joaoandre26/developedwork/(list of files, cad)

Other CAD files:
CCSproj/ImpFloatfft/Debug/src/timer0A0.obj
CCSproj/TestProject/Debug/src/uart.obj
CCSproj/ImpFloatfft/Debug/src/spectral_analysisf.obj
CCSproj/ImpFloatfft/Debug/src/uart.obj
CCSproj/ImpFloatfft/Debug/src/float_fft.obj
