joaoandre26/developedwork/KicadFiles/PiezzCircuit/output/circ.pdf

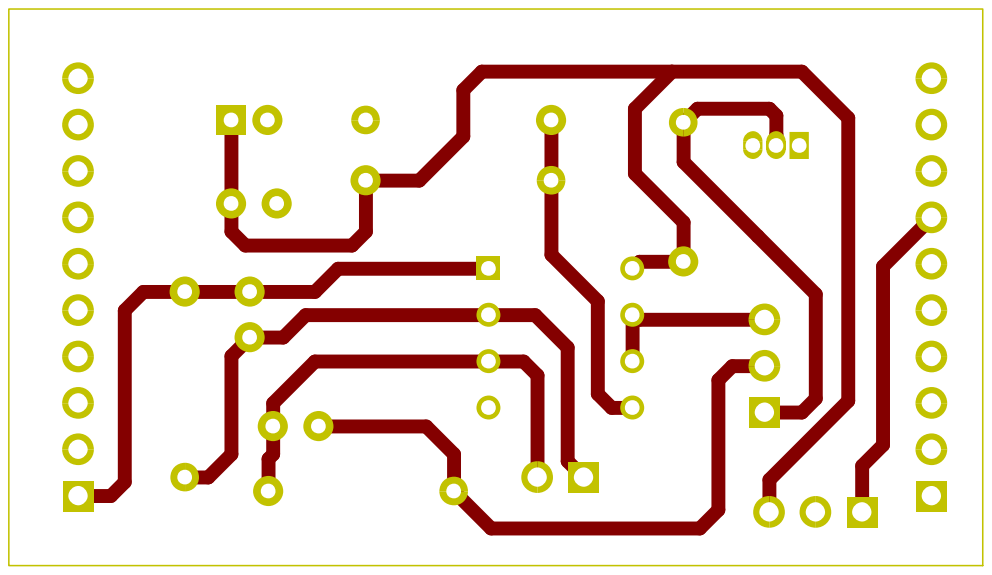
[picture p10: page 1]

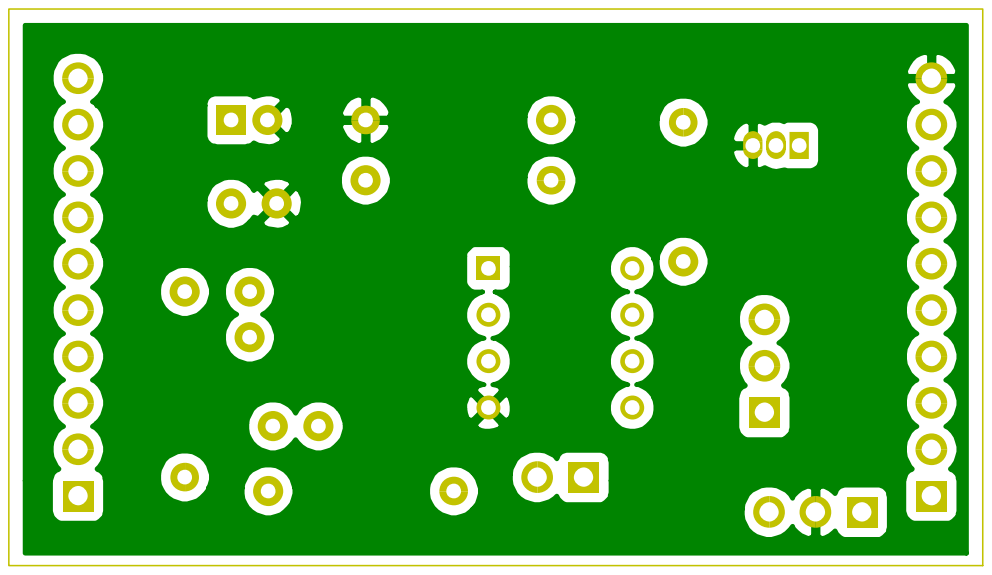
[picture p11: page 2]
