joaoandre26/developedwork/KicadFiles/AccCirc/circAcc.pdf

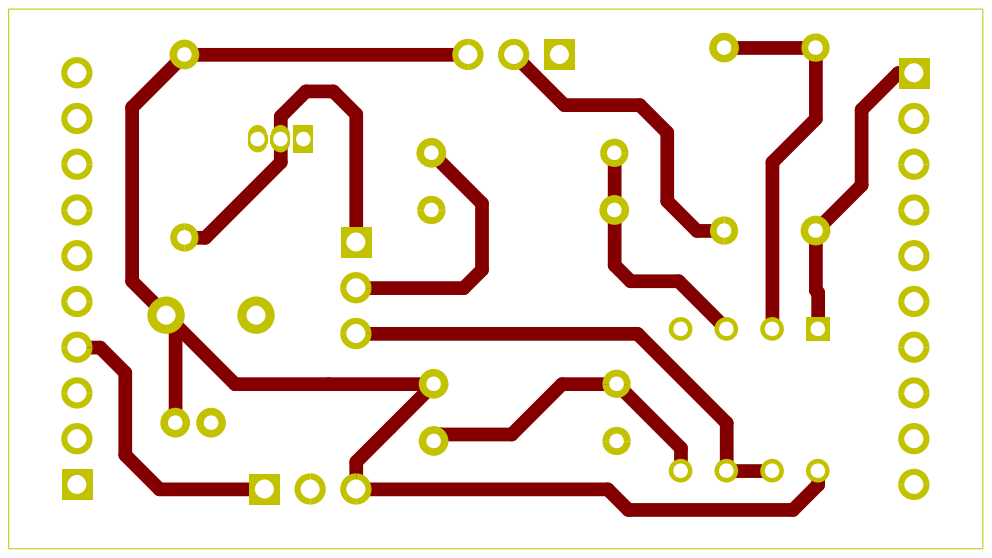
[picture p12: page 1]

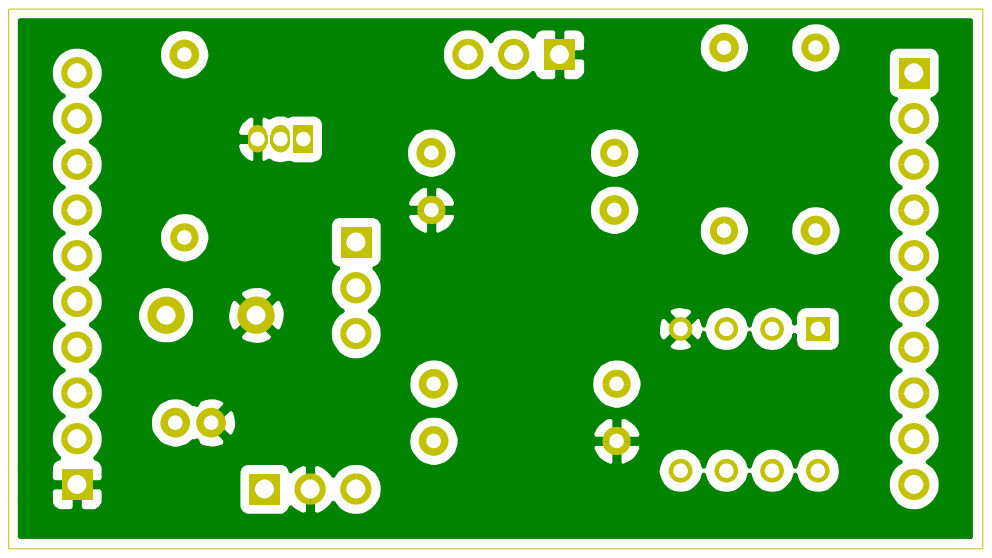
[picture p13: page 2]
