joaoandre26/developedwork/KicadFiles/AccCircV2/AccCircV2.kicad_pcb

## KiCad design KicadFiles/AccCircV2/AccCircV2.kicad_pcb (2021-06-03)

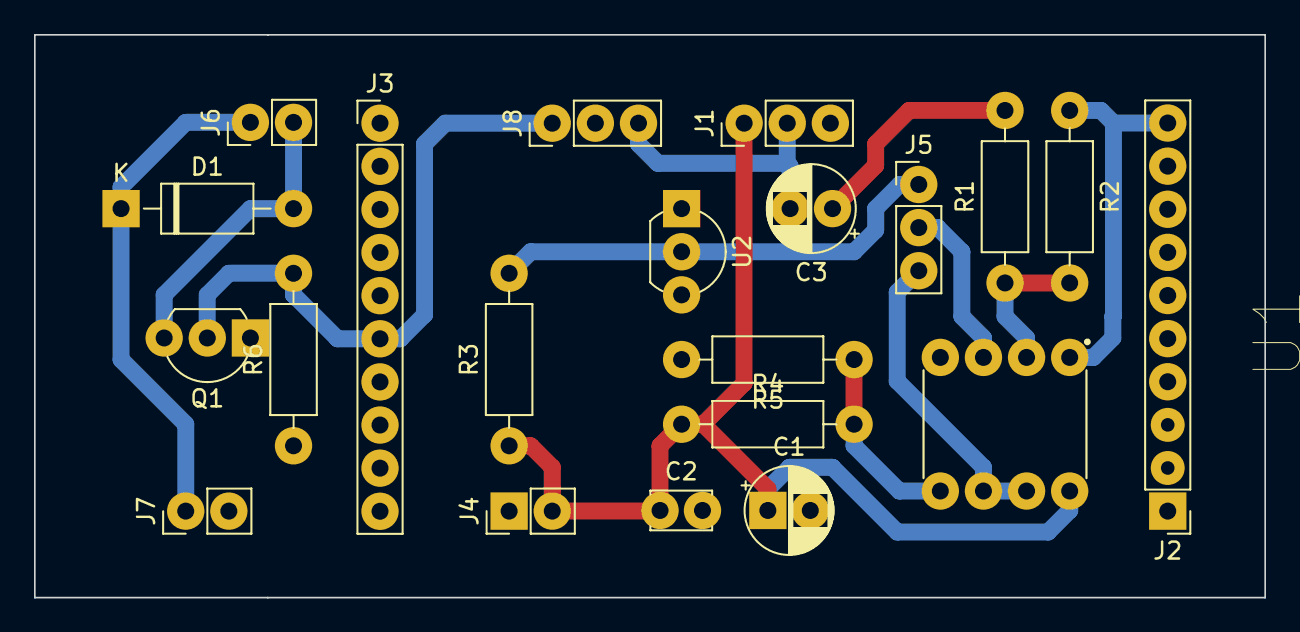
[picture p14: board AccCircV2.kicad_pcb from above]

Board: 2 copper layers, 72.5 x 33.2 mm, 21 parts (0 on the bottom side), 13 nets.

Parts:
C1, C3: 10uF; CP_Radial_D5.0mm_P2.50mm
C2: 1nF; C_Disc_D3.4mm_W2.1mm_P2.50mm
D1: 1N4001; D_DO-41_SOD81_P10.16mm_Horizontal
J1: AccelConnector; PinHeader_1x03_P2.54mm_Vertical
J2: ADCInput; PinHeader_1x10_P2.54mm_Vertical
J3: IO; PinHeader_1x10_P2.54mm_Vertical
J4: ExternalSupply3V3; PinHeader_1x02_P2.54mm_Vertical
J5: VoltageRefSel; PinHeader_1x03_P2.54mm_Vertical
J6: Solenoid Connector; PinHeader_1x02_P2.54mm_Vertical
J7: ExternalSupply5V; PinHeader_1x02_P2.54mm_Vertical
J8: ControlSig; PinHeader_1x03_P2.54mm_Vertical
Q1: TN0207; TO-92L_Inline_Wide
R1, R2, R4, R5: R; R_Axial_DIN0207_L6.3mm_D2.5mm_P10.16mm_Horizontal
R3: 180k; R_Axial_DIN0207_L6.3mm_D2.5mm_P10.16mm_Horizontal
R6: 10k; R_Axial_DIN0207_L6.3mm_D2.5mm_P10.16mm_Horizontal
U1: MCP602; DIP787W46P254L927H533Q8
U2: LM385Z-ADJ; TO-92_Inline_Wide

Connections:
+3V3: C1.1, C2.1, J1.1, J4.2, R3.1, R4.1, U1.8
+5V: D1.1, J6.1, J7.1
AccSignal: C3.2, J1.2, J8.3
GND: C1.2, C2.2, J1.3, J3.10, J4.1, J7.2, J8.2, Q1.1, R5.2, R6.1, U1.4, U2.1, U2.3
unnamed: C3.1, R1.2
unnamed: D1.2, J6.2, Q1.3
unnamed: J2.10, R2.1, U1.1
unnamed: J5.2, U1.3
unnamed: R1.1, R2.2, U1.2
unnamed: R4.2, R5.1, U1.5
PIN3.2: J3.6, J8.1, Q1.2, R6.2
VolDivider: J5.3, U1.6, U1.7
VolRef1V2: J5.1, R3.2, U2.2
