joaoandre26/developedwork/KicadFiles/PiezzCircuit/PiezzCircuit.kicad_pcb

## KiCad design KicadFiles/PiezzCircuit/PiezzCircuit.kicad_pcb (2020-12-22)

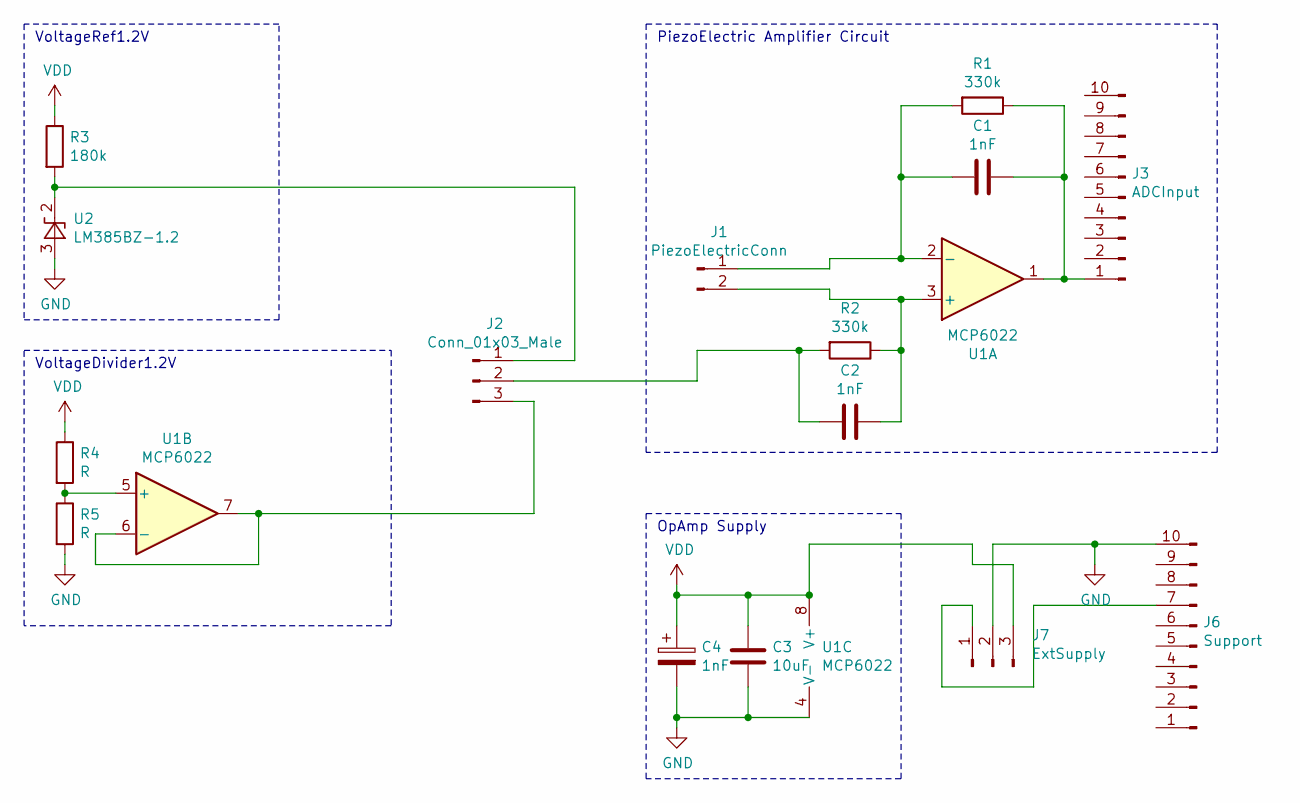
[picture p15: schematic PiezzCircuit.sch]

Parts:
C1, C2: 1nF; C_Rect_L4.0mm_W2.5mm_P2.50mm
C3: 10uF; C_Rect_L4.0mm_W2.5mm_P2.50mm
C4: 1nF; CP_Radial_D5.0mm_P2.00mm
J1: PiezoElectricConn; PinHeader_1x02_P2.54mm_Vertical
J2: Conn_01x03_Male; PinHeader_1x03_P2.54mm_Vertical
J3: ADCInput; PinHeader_1x10_P2.54mm_Vertical
J6: Support; PinHeader_1x10_P2.54mm_Vertical
J7: ExtSupply; PinHeader_1x03_P2.54mm_Horizontal
R1, R2: 330k; R_Axial_DIN0207_L6.3mm_D2.5mm_P10.16mm_Horizontal
R3: 180k; R_Axial_DIN0207_L6.3mm_D2.5mm_P7.62mm_Horizontal
R4, R5: R; R_Axial_DIN0207_L6.3mm_D2.5mm_P10.16mm_Horizontal
U1: MCP6022; DIP787W46P254L927H533Q8
U2: LM385BZ-1.2; TO-92_Inline

Connections:
GND: C3.2, C4.2, J6.10, J7.2, R5.2, U1.4 (V-), U2.3 (A)
unnamed: C1.1, J3.1, R1.1, U1.1
unnamed: C1.2, J1.1, R1.2, U1.2 (-)
unnamed: C2.1, J1.2, R2.1, U1.3 (+)
unnamed: C2.2, J2.2, R2.2
unnamed: J2.1, R3.2, U2.2 (K)
unnamed: J2.3, U1.6 (-), U1.7
unnamed: J6.7, J7.1
unnamed: R4.2, R5.1, U1.5 (+)
VDD: C3.1, C4.1, J7.3, R3.1, R4.1, U1.8 (V+)

Notes on the sheet:
VoltageRef1.2V
VoltageDivider1.2V
PiezoElectric Amplifier Circuit
OpAmp Supply

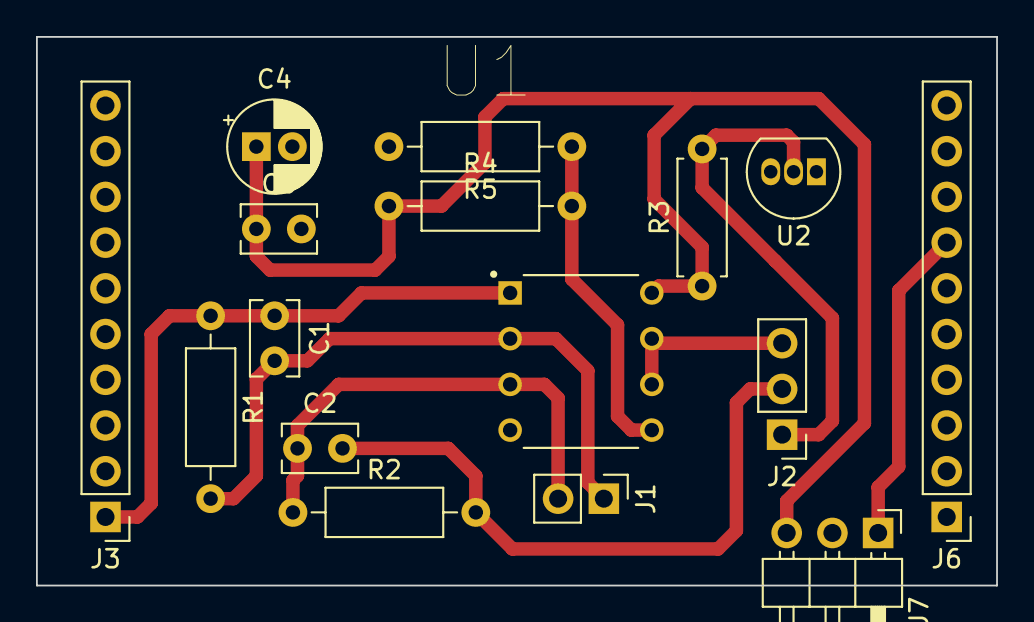
[picture p16: board PiezzCircuit.kicad_pcb from above]

Board: 2 copper layers, 53.3 x 30.5 mm, 16 parts (0 on the bottom side), 10 nets.
