joaoandre26/developedwork/KicadFiles/AccCirc/AccCirc.kicad_pcb

## KiCad design KicadFiles/AccCirc/AccCirc.kicad_pcb (2020-12-10, an earlier design)

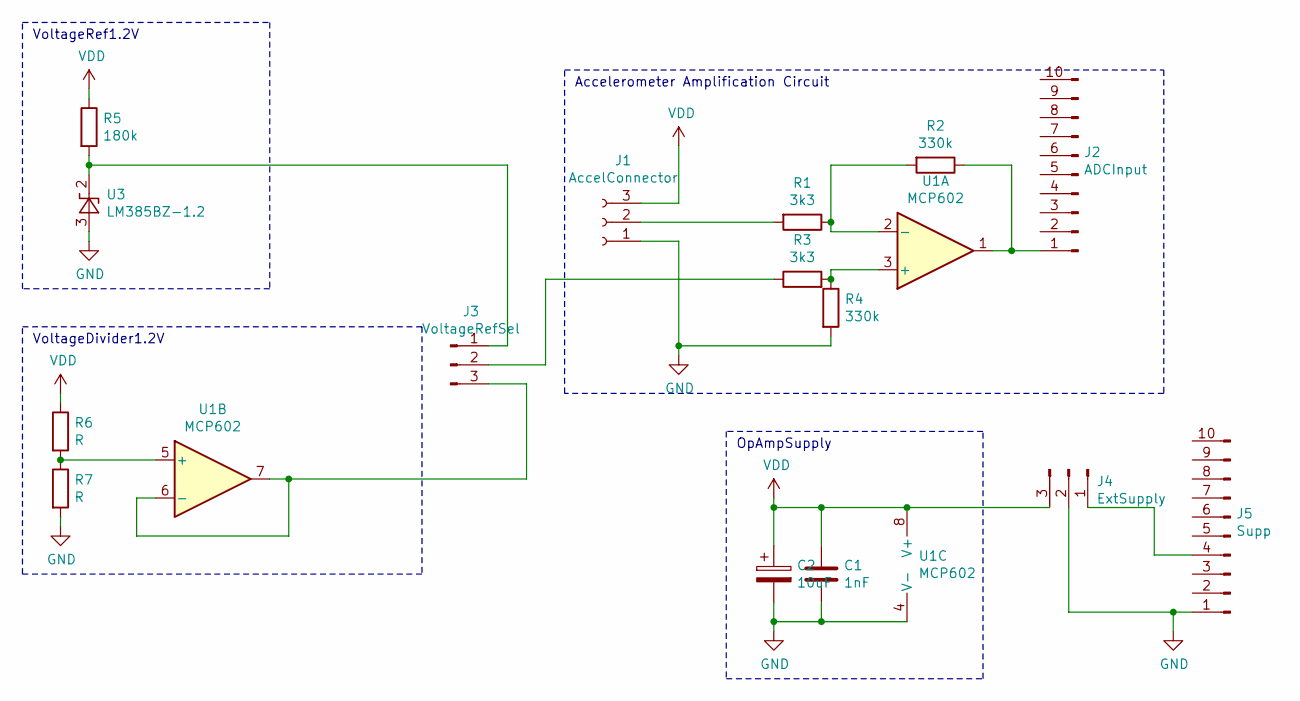
[picture p17: schematic AccCirc.sch]

Parts:
C1: 1nF; C_Disc_D10.5mm_W5.0mm_P5.00mm
C2: 10uF; C_Radial_D5.0mm_H11.0mm_P2.00mm
J1: AccelConnector; PinSocket_1x03_P2.54mm_Horizontal
J2: ADCInput; PinHeader_1x10_P2.54mm_Vertical
J3: VoltageRefSel; PinHeader_1x03_P2.54mm_Vertical
J4: ExtSupply; PinSocket_1x03_P2.54mm_Horizontal
J5: Supp; PinHeader_1x10_P2.54mm_Vertical
R1, R3: 3k3; R_Axial_DIN0207_L6.3mm_D2.5mm_P10.16mm_Horizontal
R2, R4: 330k; R_Axial_DIN0207_L6.3mm_D2.5mm_P10.16mm_Horizontal
R5: 180k; R_Axial_DIN0207_L6.3mm_D2.5mm_P10.16mm_Horizontal
R6, R7: R; R_Axial_DIN0207_L6.3mm_D2.5mm_P10.16mm_Horizontal
U1: MCP602; DIP787W46P254L927H533Q8
U3: LM385BZ-1.2; TO-92_Inline

Connections:
GND: C1.2, C2.2, J1.1, J4.2, J5.1, R4.2, R7.2, U1.4 (V-), U3.3 (A)
unnamed: J1.2, R1.2
unnamed: J2.1, R2.1, U1.1
unnamed: J3.1, R5.2, U3.2 (K)
unnamed: J3.2, R3.1
unnamed: J3.3, U1.6 (-), U1.7
unnamed: J4.1, J5.4
unnamed: R1.1, R2.2, U1.2 (-)
unnamed: R3.2, R4.1, U1.3 (+)
unnamed: R6.2, R7.1, U1.5 (+)
VDD: C1.1, C2.1, J1.3, J4.3, R5.1, R6.1, U1.8 (V+)

Notes on the sheet:
Accelerometer Amplification Circuit
VoltageRef1.2V
VoltageDivider1.2V
OpAmpSupply

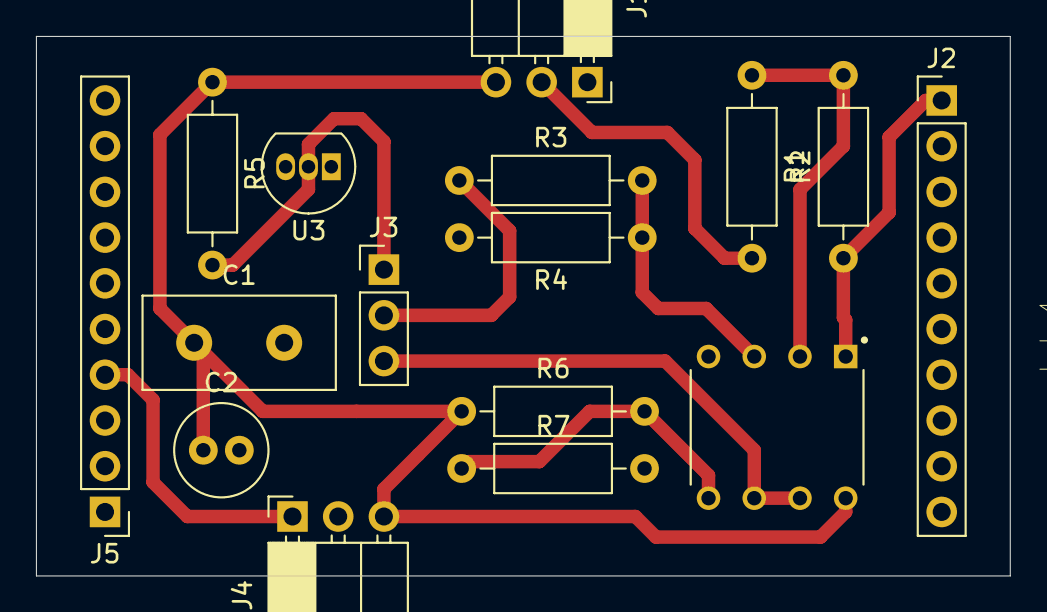
[picture p18: board AccCirc.kicad_pcb from above]

Board: 2 copper layers, 54.1 x 30.0 mm, 16 parts (0 on the bottom side), 11 nets.
