joaoandre26/developedwork/CCSproj/ImpFloatfft/src/float_fft.c

/**********************************************************/
/* fft.c                                                  */
/* (c) Douglas L. Jones                                   */
/* University of Illinois at Urbana-Champaign             */
/* January 19, 1992                                       */
/*                                                        */
/*   fft: in-place radix-2 DIT DFT of a complex input     */
/*                                                        */
/*   input:                                               */
/* n: length of FFT: must be a power of two               */
/* m: n = 2**m                                            */
/*   input/output                                         */
/* x: double array of length n with real part of data     */
/* y: double array of length n with imag part of data     */
/*                                                        */
/*   Permission to copy and use this program is granted   */
/*   under a Creative Commons "Attribution" license       */
/*   http://creativecommons.org/licenses/by/1.0/          */
/**********************************************************/
#ifndef FLOAT_FFT_C
#define FLOAT_FFT_C

#include <math.h>
#include "float_fft.h"

void float_fft(double *fr, double *fi, int m, int n)
{
    int i,j,k,n1,n2;
    double c,s,e,a,t1,t2;

    j = 0; /* bit-reverse */
    n2 = n/2;
    for (i=1; i < n - 1; i++)
    {
    n1 = n2;
    while ( j >= n1 )
    {
        j = j - n1;
        n1 = n1/2;
    }
    j = j + n1;

    if (i < j)
    {
        t1 = fr[i];
        fr[i] = fr[j];
        fr[j] = t1;
        t1 = fi[i];
        fi[i] = fi[j];
        fi[j] = t1;
    }
    }


    n1 = 0; /* FFT */
    n2 = 1;

    for (i=0; i < m; i++)
    {
    n1 = n2;
    n2 = n2 + n2;
    e = -6.283185307179586/n2;
    a = 0.0;

    for (j=0; j < n1; j++)
    {
        c = cos(a);
        s = sin(a);
        a = a + e;

        for (k=j; k < n; k=k+n2)
        {
        t1 = c*fr[k+n1] - s*fi[k+n1];
        t2 = s*fr[k+n1] + c*fi[k+n1];
        fr[k+n1] = fr[k] - t1;
        fi[k+n1] = fi[k] - t2;
        fr[k] = fr[k] + t1;
        fi[k] = fi[k] + t2;
        }
    }
    }
}
#endif
