joaoandre26/developedwork/CCSproj/TestDrivers/src/timer0A1.h

/*
 * timer0A1.h
 *
 *  Created on: 04/12/2020
 *      Author: JoaoAndre
 */

#ifndef SRC_TIMER0A1_H_
#define SRC_TIMER0A1_H_

#include <msp430.h>
#include <stdint.h>

void configTimer0A1(void);
void configIO(void);
void configTimerA1(void);
void enTimer0A1(void);
void disTimer0A1(void);


#endif /* SRC_TIMER0A1_H_ */
