joaoandre26/developedwork/(commit log)

2020-09-08 first commit + developed work till today
    [float_fft.obj, spectral_analysisf.obj, timer0A0.obj, uart.obj]
2020-12-10 New files
    [AccCirc-B_Cu.gbr, AccCirc-Edge_Cuts.gbr, AccCirc-F_Cu.gbr, AccCirc-NPTH-drl_map.gbr, AccCirc-NPTH.drl, AccCirc-PTH-drl_map.gbr, AccCirc-PTH.drl, AccCirc-job.gbrjob]
2020-12-22 some updates
    [AccCirc-B_Cu.gbr, AccCirc-Edge_Cuts.gbr, AccCirc-F_Cu.gbr, AccCirc-NPTH-drl_map.gbr, AccCirc-NPTH.drl, AccCirc-PTH-drl_map.gbr, AccCirc-PTH.drl, AccCircV2-B_Cu.gbr]
2021-04-19 New project CCS
    [AccCircV2-B_Cu.gbr, AccCircV2-Edge_Cuts.gbr, AccCircV2-F_Cu.gbr, AccCircV2-NPTH-drl_map.gbr, AccCircV2-NPTH.drl, AccCircV2-PTH-drl_map.gbr, AccCircV2-PTH.drl, AccCircV2-job.gbrjob]
2021-04-20 new device drivers
2021-06-03 some changes
    [AccCircV2.kicad_pcb, AccCircV2.sch]
